pabllo1127/Environmental-Monitoring-System/final.png

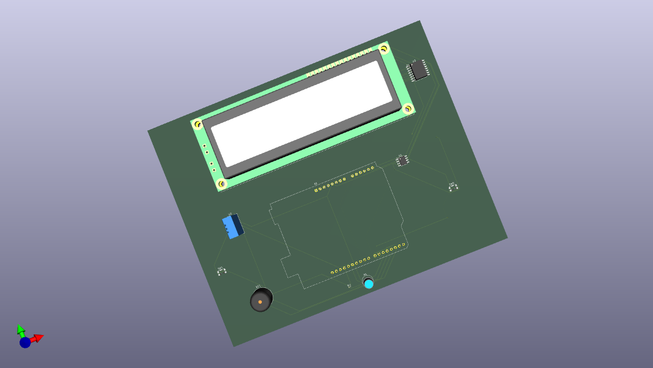
final.png
