pabllo1127/Environmental-Monitoring-System/Part1.SLDPRT

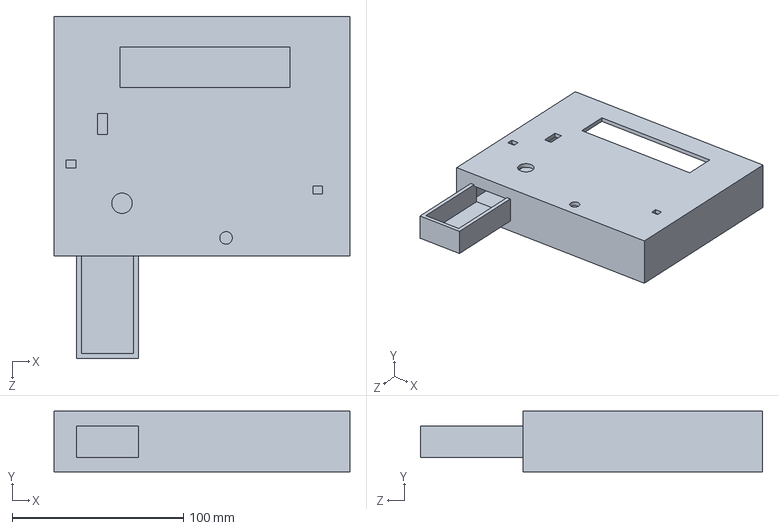
[picture p2: CAD file, 2026-04-07]
Part1.SLDPRT
173.0 x 35.5 x 200.0 mm
